KISSMonX/daisho/hw/main_board/clock_generator.sch

## KiCad design hw/main_board/clock_generator.sch (2014-01-13)

Schematic: clock_generator.sch

Parts:
C10, C11: DNP
C12, C13, C14, C15, C16, C65: 100N; Part Number GRM155R61A104KA01D
FB8: FILTER; Part Number BLM21PG221SN1D
R14: 4K7; Part Number RMCF0402JT4K70
R15: 10K; Part Number RMCF0402JT10K0
R70, R71, R72, R73, R74, R75, R76, R77: 10R; Part Number RMCF0402JT10R0
U4: SI5351C-B; Part Number SI5351C-B-GM
X3: 25M; Part Number ECS-250-8-30B-CKM
