KISSMonX/daisho/hw/main_board/ddr2.sch

## KiCad design hw/main_board/ddr2.sch (2014-01-13)

Schematic: ddr2.sch

Parts:
C210, C211, C212, C213, C214, C215, C216, C217, C218, C219, C220, C221, C222: 100N; Part Number GRM155R61A104KA01D
J1: DDR2_SDRAM_SODIMM

Notes on the sheet:
DDR2 operates in DQS single-ended mode. All DQS# == VSS
