KISSMonX/daisho/hw/main_board/fpga_configuration.sch

## KiCad design hw/main_board/fpga_configuration.sch (2014-01-13)

Schematic: fpga_configuration.sch

Parts:
C151, C152, C153, C154, C155, C156: 100N; Part Number GRM155R61A104KA01D
R43, R44, R45, R46, R47, R48, R50: 10K; Part Number RMCF0402JT10K0
R49: 1K; Part Number RMCF0402JT10K0
U1: EP4CE30F29; Part Number EP4CE30F29C8N

Notes on the sheet:
AN447: "Other I/O standards do not require attention on the maximum input voltage, such as 1.8/1.5/1.2-V LVTTL/LVCMOS, 3.0-V PCI/PCI-X, voltage-referenced, and differential I/O standards."
Figure 8-24: If you only use JTAG configuration, connect the nCONFIG pin to logic-high and the MSEL pins to GND. In addition, pull DCLK and DATA[0] to either high or low, whichever is convenient on your board.
