KISSMonX/daisho/hw/main_board/fpga_ddr2.sch

## KiCad design hw/main_board/fpga_ddr2.sch (2014-01-13)

Schematic: fpga_ddr2.sch

Parts:
C41, C42, C43, C44, C45, C46, C47, C48, C49, C50, C51, C52, C53, C54, C55, C56, C57, C58, C59, C60, C61, C62, C63, C64, C180, C181, C182, C183, C184, C185: 100N; Part Number GRM155R61A104KA01D
R1, R2, R3, R4: 49R9; Tolerance 1%; Part Number RMCF0402FT49R9
R20, R21: 1K00; Tolerance 1%; Part Number RMCF0402FT1K00
U1: EP4CE30F29

Notes on the sheet:
ODT is used for memory writes. ODT is not effective for reads, so scenario is "no-parallel" termination, which isn't ideal from a signal quality perspective. But a VTT supply and parallel termination resistors (on DQ[63..0] and DQS[7..0]) are avoided.
