KISSMonX/daisho/hw/main_board/fpga_front_end_bank_b.sch

## KiCad design hw/main_board/fpga_front_end_bank_b.sch (2014-01-13)

Schematic: fpga_front_end_bank_b.sch

Parts:
C19, C23, C31, C81, C82, C83, C84, C85, C86, C87, C88, C89: 100N; Part Number GRM155R61A104KA01D
R10, R11: 49R9; Tolerance 1%; Part Number RMCF0402FT49R9
R12, R13: 1K00; Tolerance 1%; Part Number RMCF0402FT1K00
R27: 10K; Part Number RMCF0402JT10K0
R29: 1K; Part Number RMCF0402JT1K00
U1: EP4CE30F29
U15: TPS27081A; Part Number TPS27081ADDC
