KISSMonX/daisho/hw/main_board/fpga_front_end_bank_c.sch

## KiCad design hw/main_board/fpga_front_end_bank_c.sch (2014-01-13)

Schematic: fpga_front_end_bank_c.sch

Parts:
C20, C22, C32, C71, C72, C73, C74, C75, C76, C77, C78, C79: 100N; Part Number GRM155R61A104KA01D
R30: 10K; Part Number RMCF0402JT10K0
R32: 1K; Part Number RMCF0402JT1K00
R41: 1K00; Tolerance 1%; Part Number RMCF0402FT1K00
R42: 1K0; Tolerance 1%; Part Number RMCF0402FT1K00
U1: EP4CE30F29
U16: TPS27081A; Part Number TPS27081ADDC
