KISSMonX/daisho/hw/main_board/fpga_front_end_misc.sch

## KiCad design hw/main_board/fpga_front_end_misc.sch (2014-01-13)

Schematic: fpga_front_end_misc.sch

Parts:
C18, C21, C34, C90, C91, C92, C93, C94, C95: 100N; Part Number GRM155R61A104KA01D
R23, R24: 1K00; Tolerance 1%; Part Number RMCF0402FT1K00
R36, R51: 10K; Part Number RMCF0402JT10K0
R38: 1K; Part Number RMCF0402JT1K00
U1: EP4CE30F29
U17: TPS27081A; Part Number TPS27081ADDC

Notes on the sheet:
nCEO, INIT_DONE, CRC_ERROR driven during configuration.
nCEO is open-drain during configuration.
INIT_DONE is open-drain during configuration, only if INIT_DONE output is enabled in bitstream.
CRC_ERROR is open-drain during configuration, only if bitstream CRC error detection is enabled.
Avoid use of VREF pins as I/O, as they have higher pin capacitance, and therefore are slow down both input and output signals.
Only JTAG programming mode is supported. PS (passive serial) is not supported due to Bank 1 VCCIO requirement not being met.
AN592: "The VREF pin is used mainly for voltage bias and does not source or sink much current. You can create the voltage with a regulator or resistor divider network."
