KISSMonX/daisho/hw/main_board/fpga_power.sch

## KiCad design hw/main_board/fpga_power.sch (2014-01-13)

Schematic: fpga_power.sch

Parts:
C4001, C4002, C4003, C4004, C4005, C4006, C4007, C4008, C4009, C4010, C4011, C4012, C4013, C4014, C4015, C4016, C4017, C4018, C4019, C4020, C4021, C4022, C4023, C4024, C4025, C4026, C4027, C4028, C4029, C4030, C4031, C4032, C4033, C4034, C4035, C4036, C4037, C4038, C4039, C4040, C4041, C4042, C4043, C4044, C4045, C4046, C4047, C4048, C4049, C4050, C4060, C4061, C4062, C4063, C4064, C4065, C4066, C4067: 100N; Part Number GRM155R61A104KA01D
FB7: FILTER; Part Number BLM21PG221SN1D
U1: EP4CE30F29
