KISSMonX/daisho/hw/main_board/fpga_usb0.sch

## KiCad design hw/main_board/fpga_usb0.sch (2014-01-13)

Schematic: fpga_usb0.sch

Parts:
C24, C25, C26, C27, C28, C29: 100N; Part Number GRM155R61A104KA01D
R39: 1K00; Tolerance 1%; Part Number RMCF0402FT1K00
R40: 10K; Part Number RMCF0402JT10K0
U1: EP4CE30F29
