KISSMonX/daisho/hw/main_board/front_end.sch

## KiCad design hw/main_board/front_end.sch (2014-01-13)

Schematic: front_end.sch

Parts:
C33: 100N; Part Number GRM155R61A104KA01D
J2: SAMTEC_QTH-090-D
R33: 10K; Part Number RMCF0402JT10K0
R35: 1K; Part Number RMCF0402JT1K00
U13: TPS27081A; Part Number TPS27081ADDC

Notes on the sheet:
Ground unused pins at FPGA to ensure low impedance to ground?
Ground unused pins at front-end side, assuming FPGA will be configured not to drive those pins?
