KISSMonX/daisho/hw/main_board/main_board.sch

## KiCad design hw/main_board/main_board.sch (2014-01-13)

Schematic: main_board.sch

Parts:
H1, H2, H4, H5, H6, H7, H8: HOLE
