KISSMonX/daisho/hw/main_board/microcontroller.sch

## KiCad design hw/main_board/microcontroller.sch (2014-01-13)

Schematic: microcontroller.sch

Parts:
C5, C35, C36, C200, C201: 100N; Part Number GRM155R61A104KA01D
C202, C203: 33P; Part Number GRM1555C1H330JA01D
C204: 10N; Part Number GRM21BR72E103KW03L
C205: 10N; Part Number GRM155R71E103KA01D
D3: LED; Part Number QTLP601C4TR
D4: LED; Part Number QTLP600CYTR
FB3: FILTER; Part Number BLM21PG221SN1D
J3: GSG-USB-MICRO-B-SHIELD
J4: CONN_5X2; Part Number GRPB052VWQS
J6: HIROSE_DM3D; Part Number DM3D-SF
P1, P3: CONN_1
P2: CONN_5X2
Q1: BC857
R5, R28, R52, R53, R54, R55: 10K; Part Number RMCF0402JT10K0
R31, R34: 470R; Part Number RMCF0402JT470R
R37, R57, R58: 1K; Part Number RMCF0402JT1K00
R59: 1K5; Part Number RMCF0402JT1K50
R60: 100R; Part Number RMCF0402JT100R
R61, R62: 33R; Part Number RMCF0402JT33R0
R64: 3K; Part Number RMCF0402FT3K00
R65: 24K; Part Number RMCF0402JT24K0
R106, R107, R108, R109, R110, R111, R112: 47K; Part Number RMCF0402JT47K0
SW1: SW_PUSH; Part Number EVQ-P7A01K
U3: LPC11U1X; Part Number LPC11U14FBD48/201
U18: 74LVC2T45; Part Number SN74LVC2T45DCU
U19: GSG-IP4220CZ6; Part Number IP4220CZ6,125
U20: INV1; Part Number 74AHC1GU04GW,125
X2: 12M; Part Number 7B-12.000MAAJ-T

Notes on the sheet:
General purpose indicator
Power indicator
USB 2.0 full-speed programming port
General purpose pushbutton, Shared with DDR2 SPD address signal
MicroSD card socket
Voltage shifter for 1.8V signals from FPGA to microcontroller
Direct access to FPGA JTAG
Serial Wire Debug
Enforce VCCIO default voltage supply and front end power are exclusive.
DIR=L: B -> A
