KISSMonX/daisho/hw/main_board/power.sch

## KiCad design hw/main_board/power.sch (2014-01-13)

Schematic: power.sch

Parts:
C6, C7, C17, C30, C248, C250: 10U; Part Number GRM21BR61A106KE19L
C8, C9, C249: 470P; Part Number GRM1555C1H471JA01D
C37, C240: 22U; Part Number C3225X5R1A226M
C38, C39, C245: 22U; Part Number C3216X5R0J226K
C40: 100N; Part Number GRM188R61E104KA01D
C230, C231, C232: 100N; Part Number GRM155R61A104KA01D
C241: 100N; Part Number GRM155R71A104KA10D
C242: 10N; Part Number GRM155R71E103KA01D
C243: 2N2; Part Number GRM155R72A222KA01D
C251: 33P; Part Number GRM1555C1H330JA01D
D1, D2: DIODESCH; Part Number B340A-13-F
J7: BARREL_JACK; Part Number PJ-102AH
L6: 2N2; Part Number VLP8040T-2R2N
L7, L8: 4U7; Part Number NRG4026T4R7M
R6, R91: 47K; Part Number RMCF0402JT47K0
R7, R78, R82, R83, R96, R101, R102, R103: 10K; Part Number RMCF0402JT10K0
R19, R22: 174K; Tolerance 1%; Part Number RMCF0402FT174K
R25, R26, R98: 105K; Tolerance 1%; Part Number RMCF0402FT105K
R79: 47K0; Tolerance 1%; Part Number RMCF0402FT47K0
R80, R93: 10K0; Tolerance 1%; Part Number RMCF0402FT10K0
R81: 249R; Tolerance 1%; Part Number RMCF0402FT249R
R92: 12K7; Tolerance 1%; Part Number RMCF0402FT12K7
R94: 6K34; Part Number RMCF0402FT6K34
R95: 158K; Part Number RMCF0402FT158K
R97: 107K; Tolerance 1%; Part Number RMCF0402FT107K
R99, R100: 100K; Tolerance 1%; Part Number RMCF0402FT100K
R104: 165K; Tolerance 1%; Part Number RMCF0402FT165K
R105: 137K; Tolerance 1%; Part Number RMCF0402FT137K
U6, U10, U14: MIC5207YM5; Part Number MIC5207YM5
U8: TPS2113A; Part Number TPS2113ADRB
U9: TPS2065C-2; Part Number TPS2065CDGN-2
U11: TPS54218; Part Number TPS54218RTE
U12: TPS62420; Part Number TPS62420DRC

Notes on the sheet:
FPGA VCCIO, DDR2, and USB 3.0 I/O supply
FPGA PLL supply
USB 3.0 internal supply
FPGA VCCINT supply
Clock generator supply
Microcontroller and front end EEPROM supply
V1P8 supply must come up at or before V3P3A to satisfy Si5351C-B sequencing requirement.
ALT/USB Priority Power MUX ALT power preferred over USB. ALT selected when ALT voltage >= 4.5V. Current limit is 2A.
USB OTG Power Switch
