KISSMonX/daisho/hw/main_board/usb0_interfaces.sch

## KiCad design hw/main_board/usb0_interfaces.sch (2014-01-13)

Schematic: usb0_interfaces.sch

Parts:
C2: 10N; Part Number GRM21BR72E103KW03L
C3, C4: 100N; Part Number GRM155R61A104KA01D
C170, C171: 27P; Part Number GRM1555C1H270JA01D
FB1, FB2: FILTER; Part Number BLM21PG221SN1D
J5: USB3_MICRO_AB; Part Number USB3120-30
R8: 90K9; Tolerance 1%; Part Number RMCF0402FT90K9
R9, R18: 10K; Tolerance 1%; Part Number RMCF0402FT10K0
R16, R17: 10K; Part Number RMCF0402JT10K0
U2: TUSB1310A
U5: GSG-IP4220CZ6; Part Number IP4220CZ6,125
U7: USB3_ESD_SON50-10; Part Number SP3010-04UTG
X1: 40M; Tolerance 50ppm; Part Number ABM3C-40.000MHZ-D4Y-T

Notes on the sheet:
TODO: Test points here?
Errata claims SSC and non-40MHz crystals are not compatible. Use 40MHz crystal if SSC is required.
18pF CL is OK, according to datasheet max/min specs.
NOTE: USB 3.0 spec section 6.4.2 allows swapping + and - in a SuperSpeed pair.
TODO: Where to send ID for OTG support?
