KISSMonX/daisho/hw/main_board/usb0_power.sch

## KiCad design hw/main_board/usb0_power.sch (2014-01-13)

Schematic: usb0_power.sch

Parts:
C1: 1U; Part Number GRM155R60J105KE19D
C101, C102, C103, C104, C105, C106, C107, C108, C109, C110, C111, C112, C113, C114, C115, C116, C121, C122, C123, C124, C125, C126, C127, C128, C129, C130, C131, C132, C133, C134, C135, C141, C142, C143, C144, C145, C146, C147, C148, C149, C150, C160, C161, C162: 100N; Part Number GRM155R61A104KA01D
FB4, FB5, FB6: FILTER; Part Number BLM21PG221SN1D
U2: TUSB1310A

Notes on the sheet:
Internal resistors pull PHY_MODE to USB 3.0 transceiver mode.
