KISSMonX/daisho/hw/usb/main_board_if.sch

## KiCad design hw/usb/main_board_if.sch (2014-04-03, an earlier design)

Schematic: main_board_if.sch

Parts:
C120: 100N
J4: SAMTEC_QSH-090-D
P1, P2, P3, P4, P5, P6, P7: CONN_1
R38, R39, R40, R41: 10K
R42, R43: DNI
U12: ON_CAT24C256

Notes on the sheet:
EEPROM for front-end board identification
