KISSMonX/daisho/hw/usb/power.sch

## KiCad design hw/usb/power.sch (2014-04-03, an earlier design)

Schematic: power.sch

Parts:
C104, C113: 10U; Part Number GRM21BR61A106KE19L
C105: 22U; Part Number C3225X5R1A226M
C106: 33P; Part Number GRM1555C1H330JA01D
C107: 470P; Part Number GRM1555C1H471JA01D
C108, C109: 10U
C110: 4U7
C111, C112: 22U; Part Number C3216X5R0J226K
C114: 22N
C115: 27N
C116: 100N
C117: 330P
C118: 470P
C119: 22U
D2: LED
J3: BARREL_JACK; Part Number PJ-102AH
L1: ?
L2: 4U7; Part Number NRG4026T4R7M
L3: 4U7
Q1, Q2: MOSFET_P; Part AO3415A
R18, R22: ?
R19, R23, R28, R30: 10K; Part Number RMCF0402JT10K0
R20: 165K; Tolerance 1%; Part Number RMCF0402FT165K
R21, R24: ?; Tolerance 1%
R25: 137K; Tolerance 1%; Part Number RMCF0402FT137K
R26: 174K; Tolerance 1%; Part Number RMCF0402FT174K
R27: 105K; Tolerance 1%; Part Number RMCF0402FT105K
R29: 22K
R31: 9K53
R32: 49K9
R33: 86K6
R34: 470R
R35: 715R
R36: 2K21
R37: 16K5
U9: MIC5207YM5; Part Number MIC5207YM5
U10: TPS62420; Part Number TPS62420DRC
U11: TPS54821

Notes on the sheet:
USB 3.0 supply Requirements: 3.3V output: 8mA (26mW) typical Input: 8mA typical (36mW at 5V in)
USB Host/OTG supply
Reverse polarity protection
USB regulator accepts DC input from 5.5V to 12.5V. Efficiency above 0.3A is >95.5% at 5.5V input, >91.5% across all inputs. Power dissipation is 1.1W, worst case (12.5V in, 4.0A out). IC dissipation is 0.8W worst case (12.5V in, 4.0A out). USB regulator is on whenever DC power is attached. USB powe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
USB 3.0 internal supply Requirements: 1.8V output: 228mA (410mW) typical 1.1V output: 393mA (432mW) typical Input: 936mW typical (222mA at 4.2V in, 90% efficiency)
