KISSMonX/daisho/hw/usb/usb0_interfaces.sch

## KiCad design hw/usb/usb0_interfaces.sch (2014-04-03, an earlier design)

Schematic: usb0_interfaces.sch

Parts:
C1, C2: 27P; Part Number GRM1555C1H270JA01D
C3, C5, C6: 100N; Part Number GRM155R61A104KA01D
C7: 10N; Part Number GRM21BR72E103KW03L
FB1, FB2: FILTER; Part Number BLM21PG221SN1D
J1: USB3_MICRO_AB; Part Number USB3120-30
R1, R2, R6, R7: 10K; Part Number RMCF0402JT10K0
R3, R8: 10K; Tolerance 1%; Part Number RMCF0402FT10K0
R4: ?
R9: 90K9; Tolerance 1%; Part Number RMCF0402FT90K9
U1: TUSB1310A
U2: TPS2065C-2; Part Number TPS2065CDGN-2
U3: GSG-IP4220CZ6; Part Number IP4220CZ6,125
U4: USB3_ESD_SON50-10; Part Number SP3010-04UTG
X1: 40M; Tolerance 50ppm; Part Number ABM3C-40.000MHZ-D4Y-T

Notes on the sheet:
USB OTG Power Switch
TODO: Test points here?
Errata claims SSC and non-40MHz crystals are not compatible. Use 40MHz crystal if SSC is required.
18pF CL is OK, according to datasheet max/min specs.
NOTE: USB 3.0 spec section 6.4.2 allows swapping + and - in a SuperSpeed pair.
