KISSMonX/daisho/hw/usb/usb0_power.sch

## KiCad design hw/usb/usb0_power.sch (2014-04-03, an earlier design)

Schematic: usb0_power.sch

Parts:
C8, C9, C10, C11, C12, C13, C14, C15, C16, C17, C18, C19, C20, C21, C22, C23, C24, C25, C26, C27, C28, C29, C30, C31, C32, C33, C34, C35, C36, C37, C38, C40, C41, C42, C43, C44, C45, C46, C47, C48, C49, C50, C51, C52: 100N; Part Number GRM155R61A104KA01D
C39: 1U; Part Number GRM155R60J105KE19D
FB3, FB4, FB5: FILTER; Part Number BLM21PG221SN1D
U1: TUSB1310A

Notes on the sheet:
Internal resistors pull PHY_MODE to USB 3.0 transceiver mode.
