KISSMonX/daisho/hw/usb/usb1_power.sch

## KiCad design hw/usb/usb1_power.sch (2014-04-03, an earlier design)

Schematic: usb1_power.sch

Parts:
C59, C60, C61, C62, C63, C64, C65, C66, C67, C68, C69, C70, C71, C72, C73, C74, C75, C76, C77, C78, C79, C80, C81, C82, C83, C84, C85, C86, C87, C88, C89, C91, C92, C93, C94, C95, C96, C97, C98, C99, C100, C101, C102, C103: 100N; Part Number GRM155R61A104KA01D
C90: 1U; Part Number GRM155R60J105KE19D
FB8, FB9, FB10: FILTER; Part Number BLM21PG221SN1D
U5: TUSB1310A

Notes on the sheet:
Internal resistors pull PHY_MODE to USB 3.0 transceiver mode.
