KISSMonX/daisho/(commit log)

2013-11-10 Corrected pin numbering on 2x5 0.05" Sullins connector. (Used ARM for SWD/JTAG).
2013-11-10 Corrected pin numbering on Sullins 4x2 0.05" header (used for FPGA JTAG and microcontroller serial).
2013-11-10 Correct USB 3.0 micro-AB symbol to incorporate USB 3.0 ECN 017 change to Table 5-6 "USB 3.0 Micro-AB/-A Connector Pin Assignments". SSRX and SSTX pairs were reversed.
2013-11-13 Fixed pad positions on TE-1473005-4 DDR2 SO-DIMM socket.
2013-11-13 Swap USB 3.0 SS TX/RX pairs, and wire them straight through (because swapping +/- for routing is no longer necessary). Rearrange USB signal connections to USB protection ICs.
    [usb0_interfaces.sch]
2013-11-13 Add VALT net label so I can copper pour with a net name.
    [power.sch]
2013-11-13 Generalize PJ-102BH module into PJ-102[AB]H. Change DC jack from CUI PJ-102BH (2.5mm) to PJ-102AH (2.1mm).
    [power.sch]
2013-11-13 Add BARREL_JACK library, since it apparently existed only in my cache, or was otherwise disappeared from the KiCAD libraries. All the .sch files had to be updated because the list of LIBS appear in *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
    [clock_generator.sch, ddr2.sch, fpga_configuration.sch, fpga_ddr2.sch, fpga_front_end_bank_b.sch, fpga_front_end_bank_c.sch, fpga_front_end_misc.sch, fpga_power.sch]
2013-12-10 Fixed SS TX/RX swapped pairs on USB 3.0 connector. Moved USB 3.0 connector to "front" of board and cleaned up routing. Fixed DDR2 footprint and related routing. Reworked power routing near power conn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
    [main_board.brd]
2014-01-13 Replaced non-standard FPGA JTAG connector with Altera-style. Terminated microcontroller RXD/TXD with test points, since they no longer go to the JTAG connector. Moved general-purpose switch signal to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
    [microcontroller.sch]
2014-01-13 Accept KiCAD updates to timestamps in .sch files. Ugh.
    [clock_generator.sch, ddr2.sch, fpga_configuration.sch, fpga_ddr2.sch, fpga_front_end_bank_b.sch, fpga_front_end_bank_c.sch, fpga_front_end_misc.sch, fpga_power.sch]
2014-01-13 FPGA JTAG is now a 2x5 0.1" header. Microcontroller UART now exposed on test points, not JTAG header. Moved general-purpose button to a better location and to a different pin on the microcontroller. 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
    [main_board.brd]
2014-01-13 Tentative Gerbers for next PCB build.
    [main_board-1_top.gtl, main_board-2_gnd.gbr, main_board-3_inner.gbr, main_board-4_gnd.gbr, main_board-5_pwr.gbr, main_board-6_inner.gbr, main_board-7_gnd.gbr, main_board-8_bot.gbl]
2014-01-13 Updated microcontroller USB connector. Moved silkscreen writing block. Ready (again) for review for next PCB build.
    [main_board.brd]
2014-01-13 Gerbers for next round of PCB build.
    [main_board-1_top.gtl, main_board-2_gnd.gbr, main_board-3_inner.gbr, main_board-4_gnd.gbr, main_board-5_pwr.gbr, main_board-6_inner.gbr, main_board-7_gnd.gbr, main_board-8_bot.gbl]
2014-02-20 Added footprint match to TUSB1310 library symbol.
2014-02-20 Samtec QSH library and footprint.
2014-02-20 SOIC footprints.
2014-02-20 TI TPS54821 switching regulator library.
2014-02-20 USB 3.0 front-end schematic and components mapping. First attempt, far from finished.
    [main_board_if.sch, power.sch, usb.sch, usb0_fe_map.sch, usb0_interfaces.sch, usb0_power.sch, usb1_fe_map.sch, usb1_interfaces.sch]
2014-03-26 Updated usb project to Kicad bar 4730, fixed lots of library breakage. Removed _fe_map schematics, made mapping between FE connector pins and USB PHY chip more direct. Much assorted clean-up and chan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
    [main_board_if.sch, power.sch, usb.sch, usb0_fe_map.sch, usb0_interfaces.sch, usb0_power.sch, usb1_fe_map.sch, usb1_interfaces.sch]
2014-03-29 TC6416A I/O expander symbol and footprint.
2014-03-29 Added I/O expanders to control less demanding PHY signals. (Ran out of FPGA signals!) Miscellaneous schematic clean-up. Added gobs of LEDs. Added PDF of schematic for non-KiCad users.
    [main_board_if.sch, power.sch, usb.sch, usb0_interfaces.sch, usb0_power.sch, usb1_interfaces.sch, usb1_power.sch]
2014-04-03 Remove USB PHY_RESETN pull-downs. Comments about PIPE and ULPI bus considerations, USB PHY pull-ups/downs strategy, USB diff pair and VBUS switch characteristics. Added bulk capacitance to input and 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
    [main_board_if.sch, power.sch, usb.sch, usb0_interfaces.sch, usb0_power.sch, usb1_interfaces.sch, usb1_power.sch]
2014-04-03 Reverse LEDs attached to I/O expander -- sink current is higher than source. Note I/O expander I2C addresses. Specify TCA6416A package type "PW". Miscellaneous design notes. I/O expander I2C pull-ups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
    [main_board_if.sch, usb1_interfaces.sch]
