KISSMonX/daisho/(notices)

Notices in the files:
hw/main_board/clock_generator.sch:
Copyright © 2013 Jared Boone
License: GNU General Public License, version 2
hw/usb/usb0_power.sch:
Copyright © 2014 Jared Boone
